REnglert/PCB_Motor_Driver/README.md

# PCB_Motor_Driver

This my designed, printed, soldered, and tested 12V motor driver. 

## Schematic 

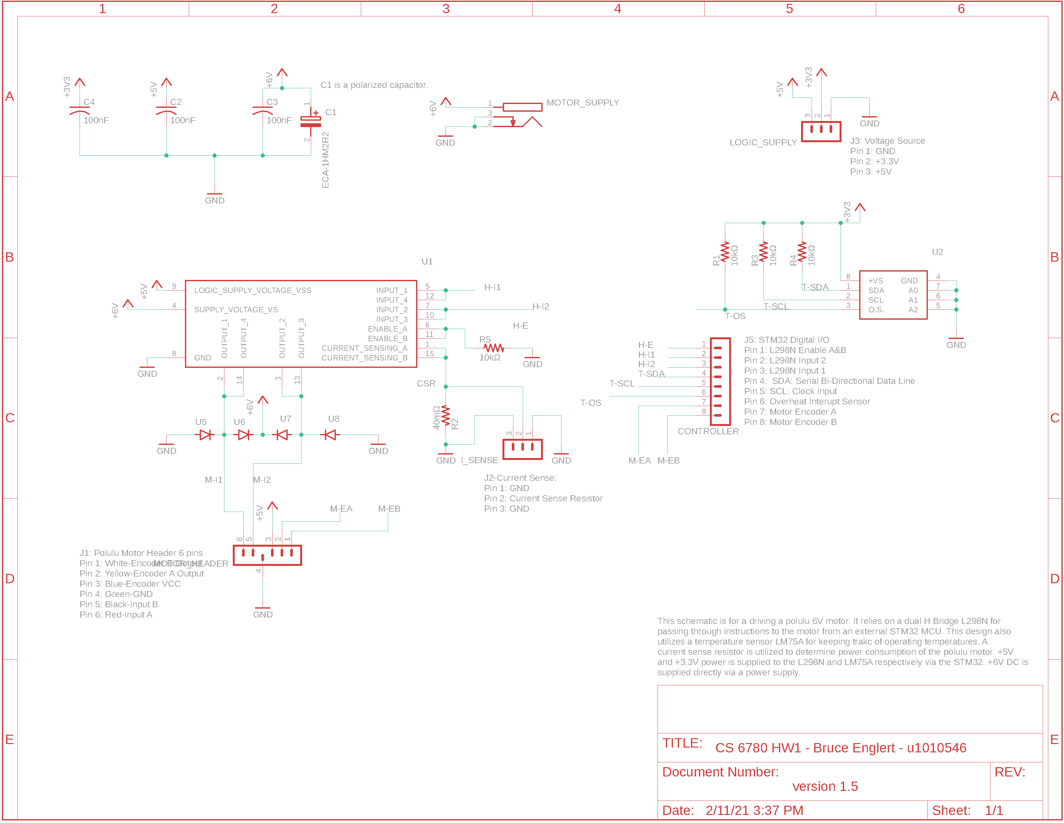
[picture p1: Schematic.PNG]
schematic


## PCB Layout 

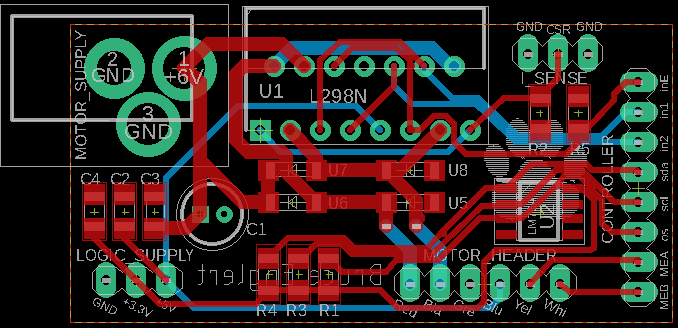
[picture p2: PCB_Layout.PNG]
layout


## Soldered Board 

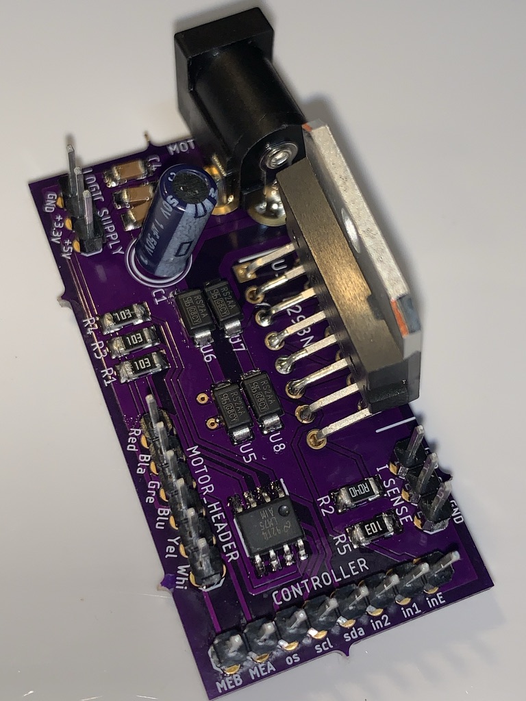
[picture p3: Soldered_Baord.PNG]
board
