REnglert/PCB_Motor_Driver/encoder_lab/Post Lab.pdf

# ECE 6780 Lab 07

Bruce Englert
U1010546
Apr. 14, 2021

## Post lab 07

### 1. What gain parameters did you end up using for your PI controller?

I ended up picking 8 for Kp and Ki.

- Describe the response of the system to speed changes.

When using 1 for the gain parameters the motor responds sluggish while with 8 it responds faster and tends to over respond but correct quickly. When using 255 for the gain settings the motor over reacts to inputs but takes longer to bounce back.

Kp = 1 & Ki = 1

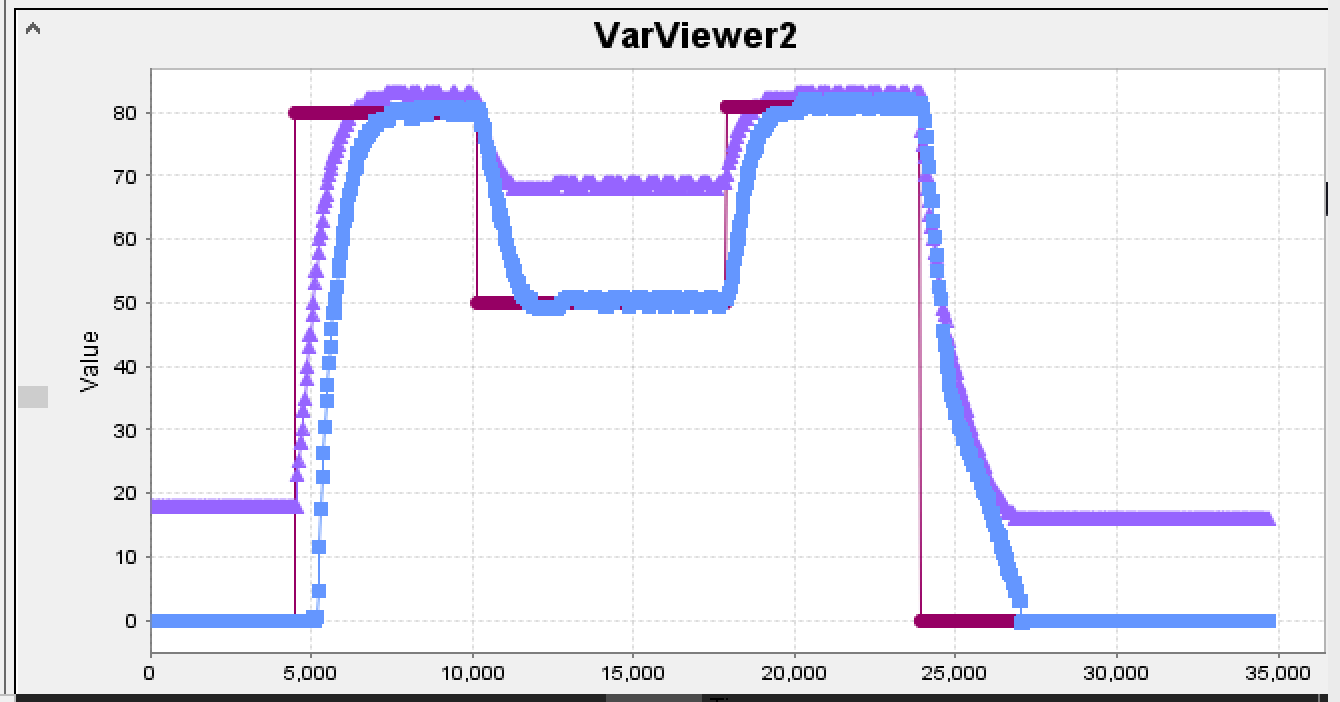
[picture p17: figure]

Kp = 8 & Ki = 8

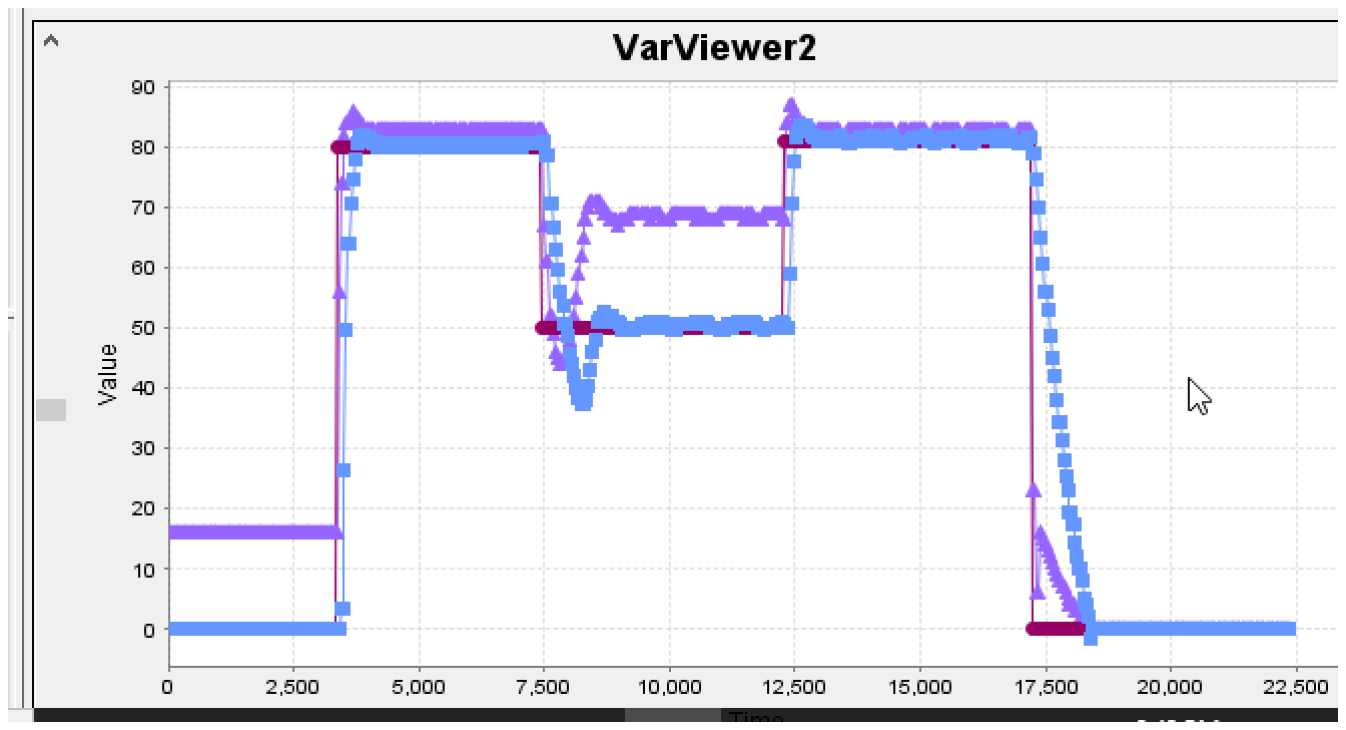
[picture p18: figure]

Kp = 255 & Ki = 255

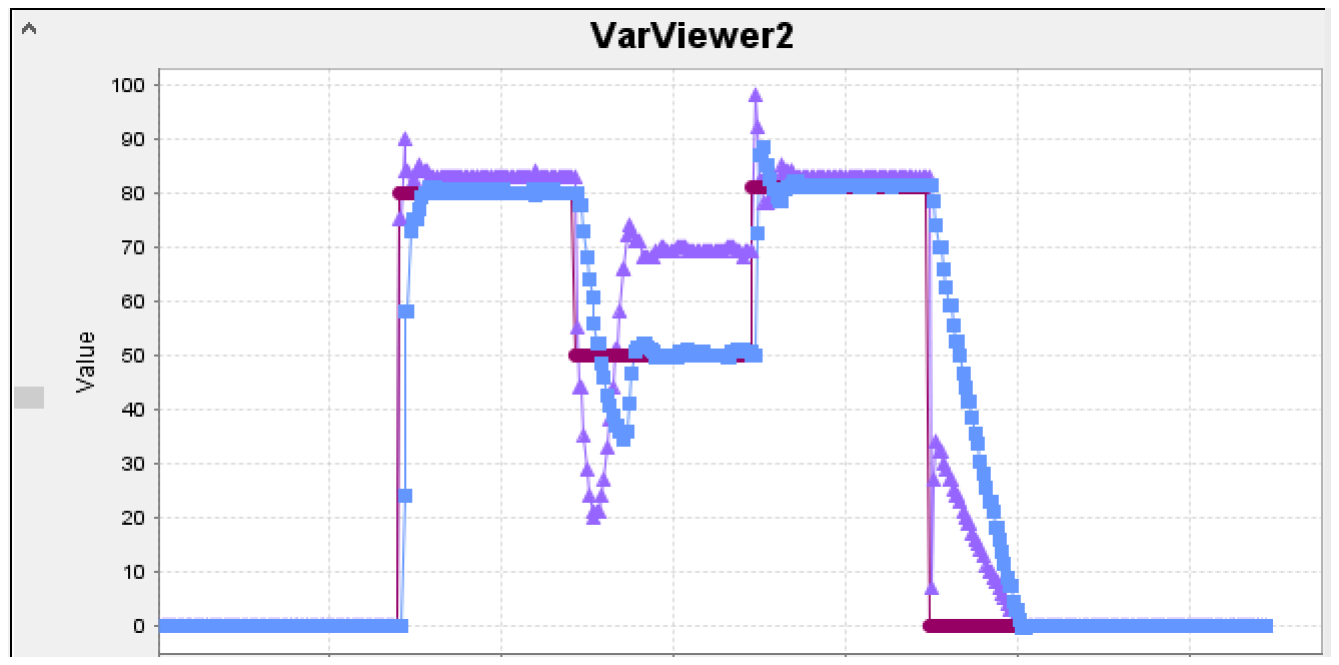
[picture p19: figure]
