REnglert/PCB_Motor_Driver/PCB_Layout_w_GND_Planes.PNG

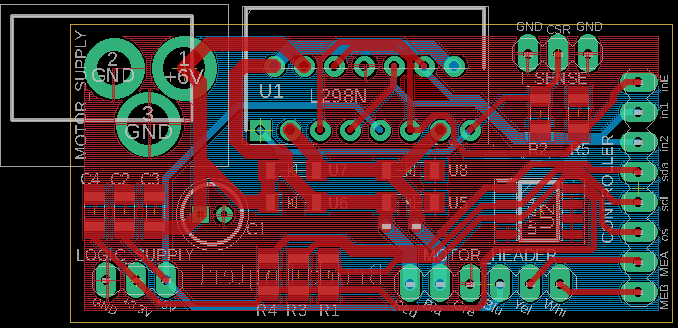
PCB_Layout_w_GND_Planes.PNG
