REnglert/PCB_Motor_Driver/SolderedBoard_1.PNG

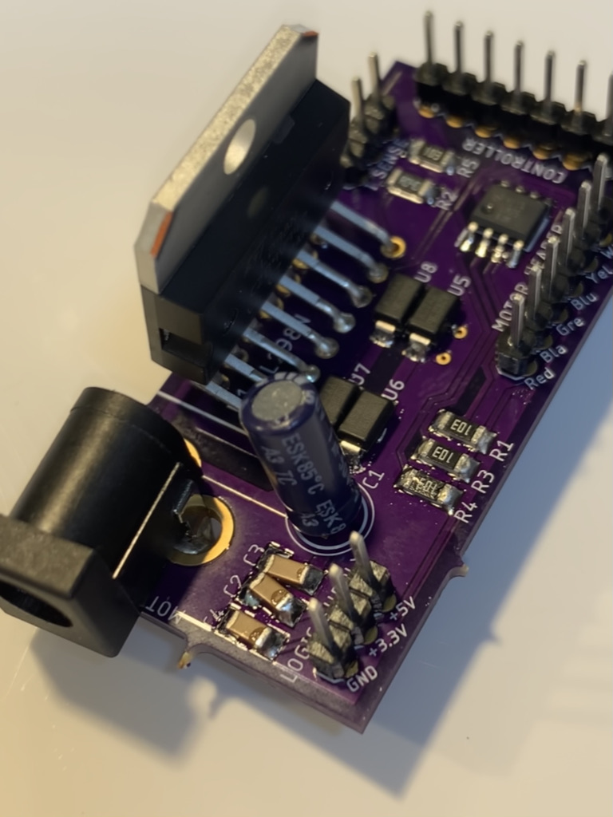
SolderedBoard_1.PNG
