REnglert/PCB_Motor_Driver/Motor_Driver.brd

## EAGLE design Motor_Driver.brd (2021-10-06)

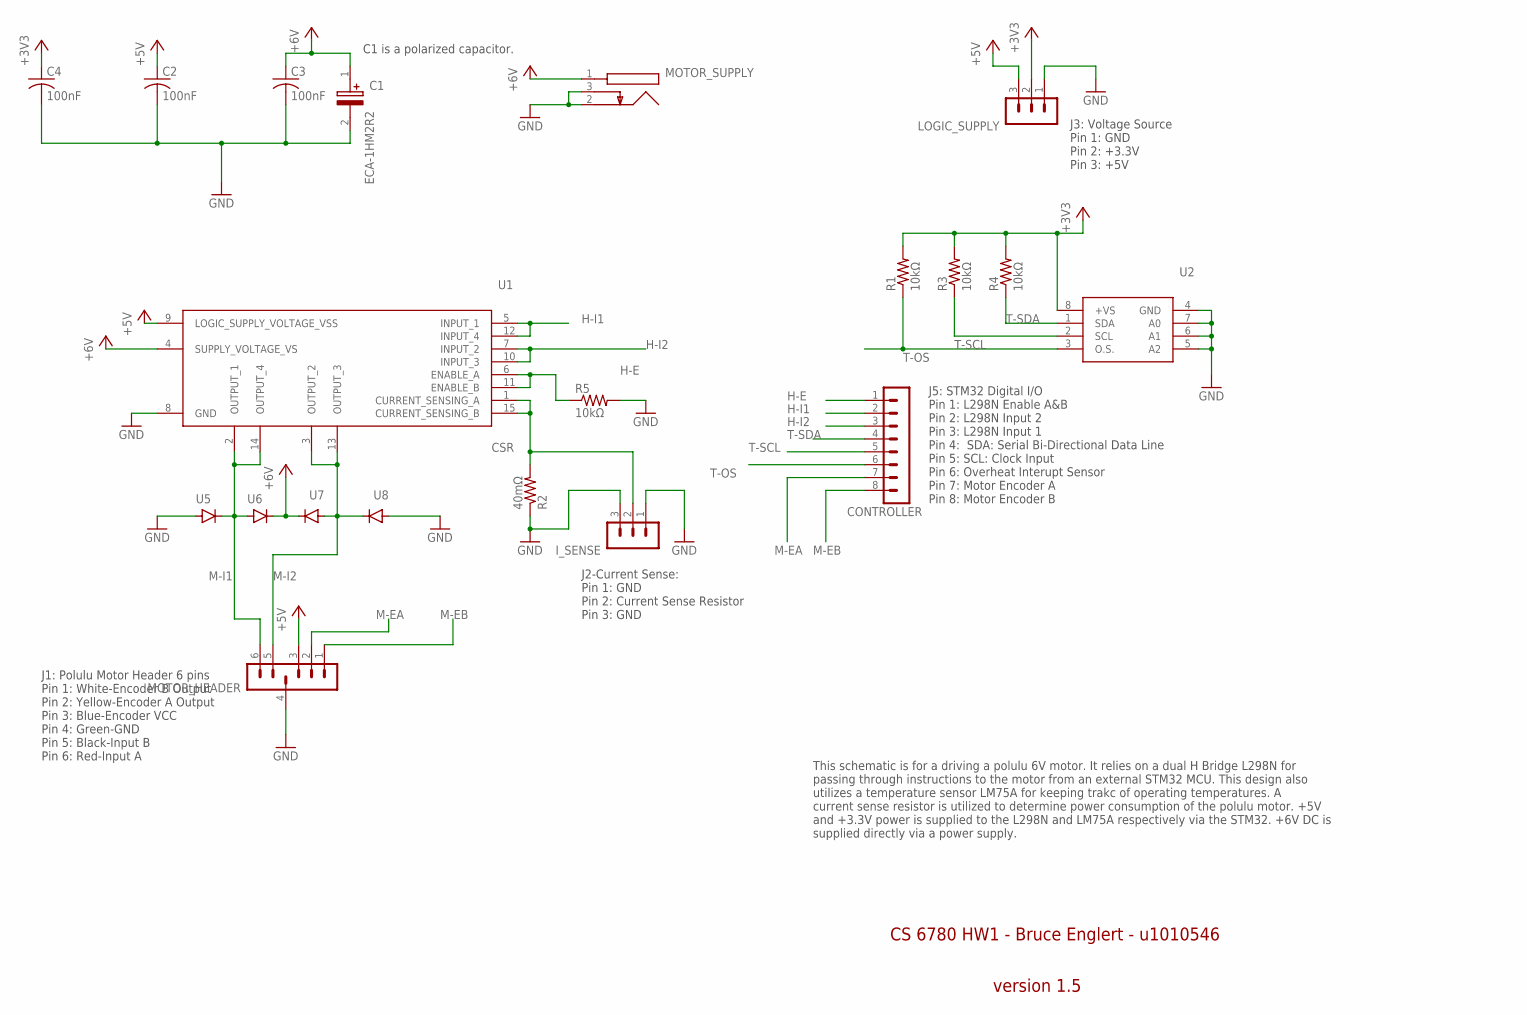
[picture p22: schematic Motor_Driver.sch]

Parts:
C1: ECA-1HM2R2; CAPPRD200W55D500H1200
C2, C3, C4: 100nF; C1206
CONTROLLER: MA08-1
I_SENSE: CURRENT_SENSE; MA03-1
LOGIC_SUPPLY: VOLTAGE_SOURCE; MA03-1
MOTOR_HEADER: MA06-1
MOTOR_SUPPLY: SUPPLY_JACK; CONSOCJ2155
R1, R3, R4, R5: 10kΩ; R1206
R2: 40mΩ; R1206
U1: L298N; TO127P500X2020X2210-15P
U2: LM75A; SOIC127P600X175-8N
U5, U6, U7, U8: GF1; SMA-DO214AC

Connections:
+3V3: C4.1, LOGIC_SUPPLY.2, R1.2, R3.2, R4.2, U2.8 (+VS)
+5V: C2.1, LOGIC_SUPPLY.3, MOTOR_HEADER.3, U1.9 (LOGIC_SUPPLY_VOLTAGE_VSS)
+6V: C1.1 (+), C3.1, MOTOR_SUPPLY.1, U1.4 (SUPPLY_VOLTAGE_VS), U6.K (C), U7.K (C)
CSR: I_SENSE.2, R2.2, U1.1 (CURRENT_SENSING_A), U1.15 (CURRENT_SENSING_B)
GND: C1.2 (-), C2.2, C3.2, C4.2, I_SENSE.1, I_SENSE.3, LOGIC_SUPPLY.1, MOTOR_HEADER.4, MOTOR_SUPPLY.2, MOTOR_SUPPLY.3, R2.1, R5.2, U1.8 (GND), U2.4 (GND), U2.5 (A2), U2.6 (A1), U2.7 (A0), U5.A, U8.A
H-E: CONTROLLER.1, R5.1, U1.6 (ENABLE_A), U1.11 (ENABLE_B)
H-I1: CONTROLLER.2, U1.5 (INPUT_1), U1.12 (INPUT_4)
H-I2: CONTROLLER.3, U1.7 (INPUT_2), U1.10 (INPUT_3)
M-EA: CONTROLLER.7, MOTOR_HEADER.2
M-EB: CONTROLLER.8, MOTOR_HEADER.1
M-I1: MOTOR_HEADER.6, U1.2 (OUTPUT_1), U1.14 (OUTPUT_4), U5.K (C), U6.A
M-I2: MOTOR_HEADER.5, U1.3 (OUTPUT_2), U1.13 (OUTPUT_3), U7.A, U8.K (C)
T-OS: CONTROLLER.6, R1.1, U2.3 (O.S.)
T-SCL: CONTROLLER.5, R3.1, U2.2 (SCL)
T-SDA: CONTROLLER.4, R4.1, U2.1 (SDA)

Notes on the sheet:
CS 6780 HW1 - Bruce Englert - u1010546
version 1.5
This schematic is for a driving a polulu 6V motor. It relies on a dual H Bridge L298N for passing through instructions to the motor from an external STM32 MCU. This design also utilizes a temperature sensor LM75A for keeping trakc of operating temperatures. A current sense resistor is utilized to d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
J1: Polulu Motor Header 6 pins Pin 1: White-Encoder B Output Pin 2: Yellow-Encoder A Output Pin 3: Blue-Encoder VCC Pin 4: Green-GND Pin 5: Black-Input B Pin 6: Red-Input A
J2-Current Sense: Pin 1: GND Pin 2: Current Sense Resistor Pin 3: GND
J3: Voltage Source Pin 1: GND Pin 2: +3.3V Pin 3: +5V
J5: STM32 Digital I/O Pin 1: L298N Enable A&B Pin 2: L298N Input 2 Pin 3: L298N Input 1 Pin 4: SDA: Serial Bi-Directional Data Line Pin 5: SCL: Clock Input Pin 6: Overheat Interupt Sensor Pin 7: Motor Encoder A Pin 8: Motor Encoder B
C1 is a polarized capacitor.

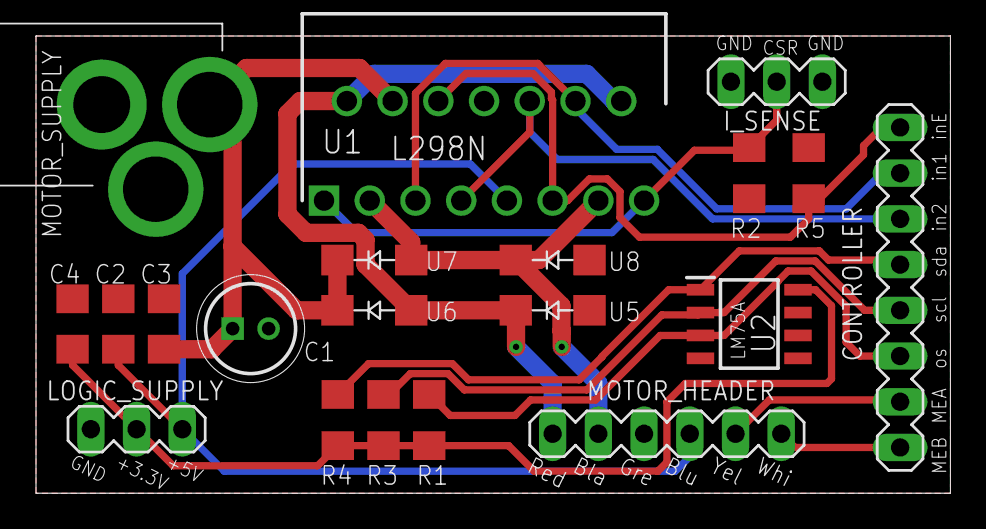
[picture p23: board Motor_Driver.brd from above]

Board: 2 copper layers, 50.8 x 25.4 mm, 20 parts (0 on the bottom side), 15 nets.
