REnglert/PCB_Motor_Driver/(commit log)

2021-10-06 upload project to public repo
    [BOM.csv, Motor_Driver.brd, Motor_Driver.sch]
2021-10-06 update schematic image
